smilg/rwm-kitty-caddy/docs/images/irl/bare.jpg

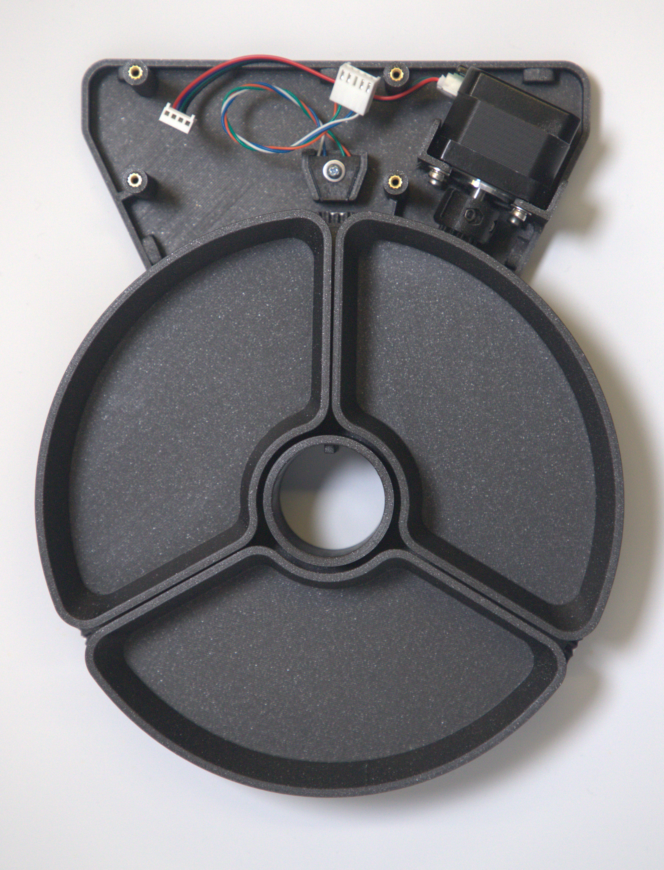
docs/images/irl/bare.jpg
