smilg/rwm-kitty-caddy/docs/images/irl/final_case_close.jpg

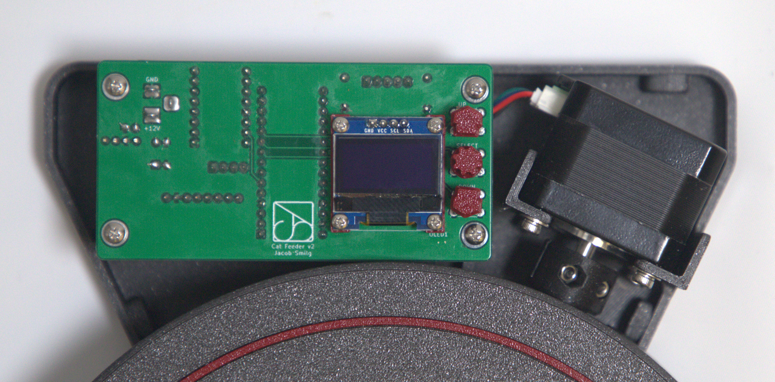
docs/images/irl/final_case_close.jpg
