smilg/rwm-kitty-caddy/docs/images/irl/final_case_off.jpg

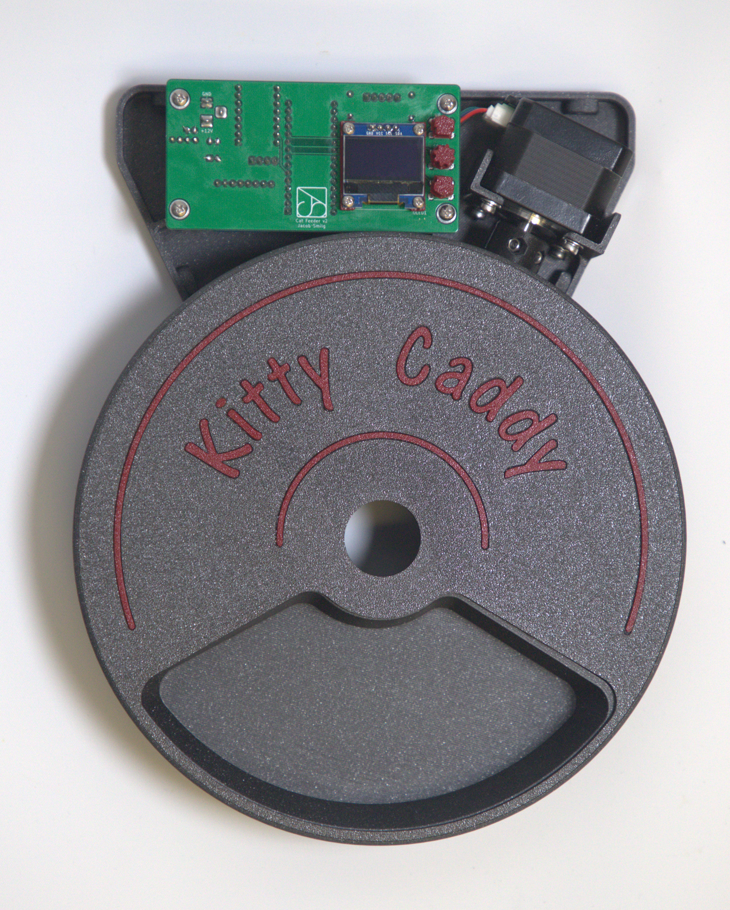
docs/images/irl/final_case_off.jpg
