smilg/rwm-kitty-caddy/ecad/CatFeeder.kicad_pcb

## KiCad design ecad/CatFeeder.kicad_pcb (2021-12-14)

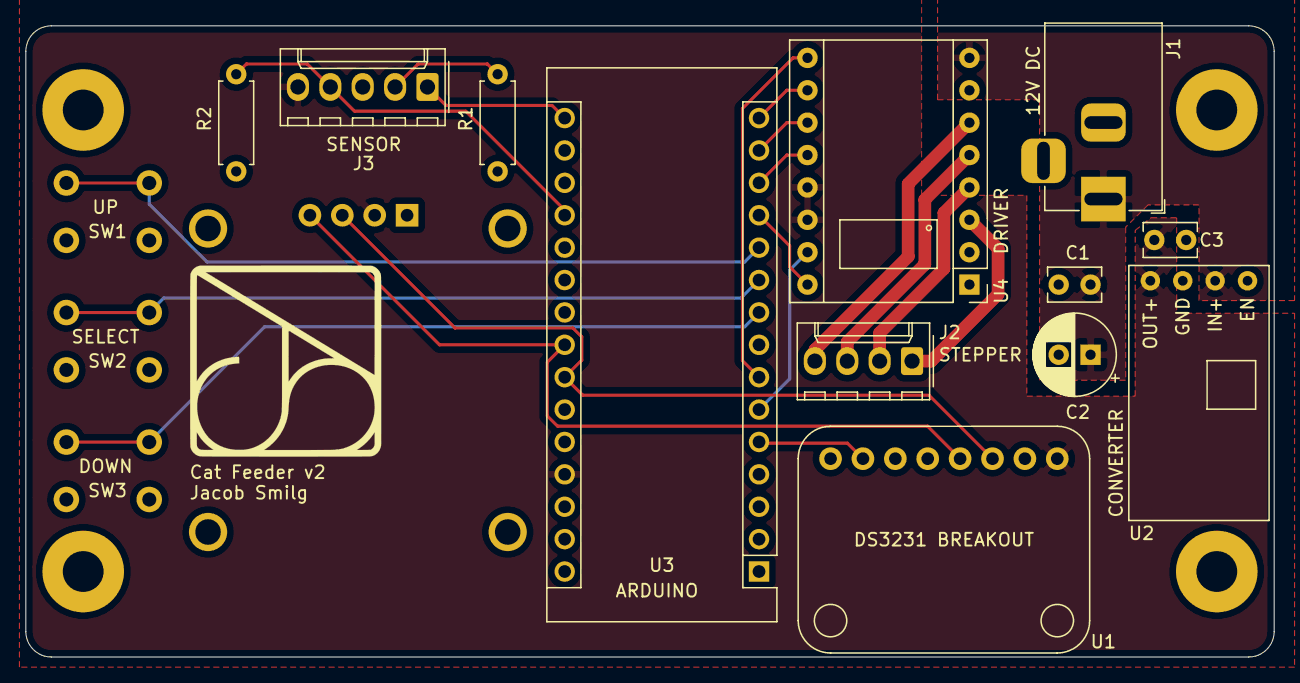
[picture p12: board CatFeeder.kicad_pcb from above]

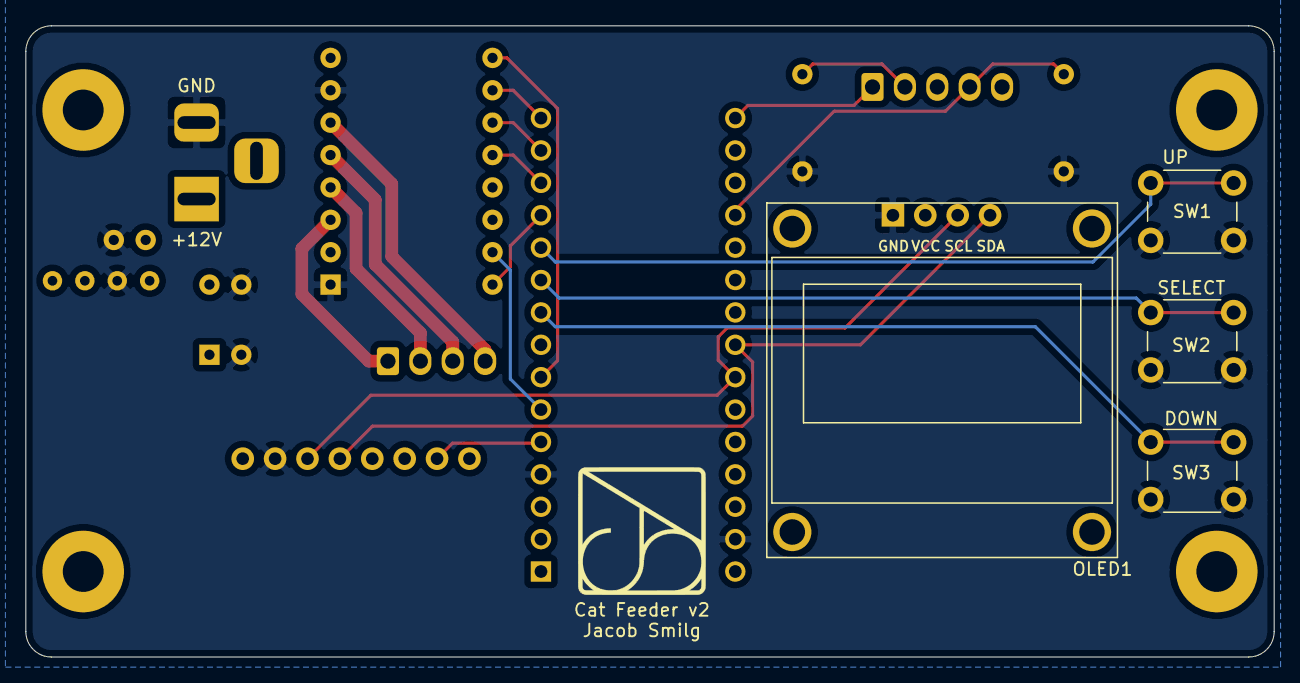
[picture p13: board CatFeeder.kicad_pcb from below]

Board: 2 copper layers, 97.9 x 49.5 mm, 16 parts (4 on the bottom side), 22 nets.

Parts:
C1, C3: 0.1μF; C_Rect_L4.0mm_W2.5mm_P2.50mm
C2: 100μF; CP_Radial_D6.3mm_P2.50mm
J1: Barrel_Jack; BarrelJack_Horizontal
J2: STEPPER; Molex_KK-254_AE-6410-04A_1x04_P2.54mm_Vertical
J3: OP740WZ; Molex_KK-254_AE-6410-05A_1x05_P2.54mm_Vertical
OLED1: I2COLEDDisplay; i2cOLED
R1: 100Ω; R_Axial_DIN0207_L6.3mm_D2.5mm_P7.62mm_Horizontal
R2: 100KΩ; R_Axial_DIN0207_L6.3mm_D2.5mm_P7.62mm_Horizontal
SW1: UP; SW_PUSH_6mm
SW2: SELECT; SW_PUSH_6mm
SW3: DOWN; SW_PUSH_6mm
U1: DS3231 BREAKOUT; DS3231Breakout
U2: BuckConverter; BuckConverterBreakout
U3: Arduino_Nano_v3.x; Arduino_Nano
U4: DRV8825; DRV8825Breakout

Connections:
1HZ_INT: U1.7, U3.5
+5V: C3.1, J3.5, OLED1.2, U1.1, U2.1, U3.27, U4.13, U4.14
+12V: C1.1, C2.1, J1.1, U2.3, U4.8
DIR: U3.12, U4.16
DOWN: SW3.2, U3.9
GND: C1.2, C2.2, C3.2, J1.2, OLED1.1, R1.2, R2.2, SW1.1, SW2.1, SW3.1, U1.2, U2.2, U3.4, U3.29, U4.1, U4.7
M0: U3.15, U4.10
M1: U3.14, U4.11
M2: U3.13, U4.12
unnamed: J2.1, U4.3
unnamed: J2.2, U4.4
unnamed: J2.3, U4.5
unnamed: J2.4, U4.6
unnamed: J3.2, R1.1
SCL: OLED1.3, U1.3, U3.24
SDA: OLED1.4, U1.4, U3.23
SELECT: SW2.2, U3.10
SENSOR: J3.4, R2.1, U3.19
SENSOR_ACTIVE: J3.1, U3.16
STEP: U3.6, U4.15
STEPPER_EN: U3.7, U4.9
UP: SW1.2, U3.11
