smilg/rwm-kitty-caddy/docs/images/irl/rev1_back_assembled.jpg

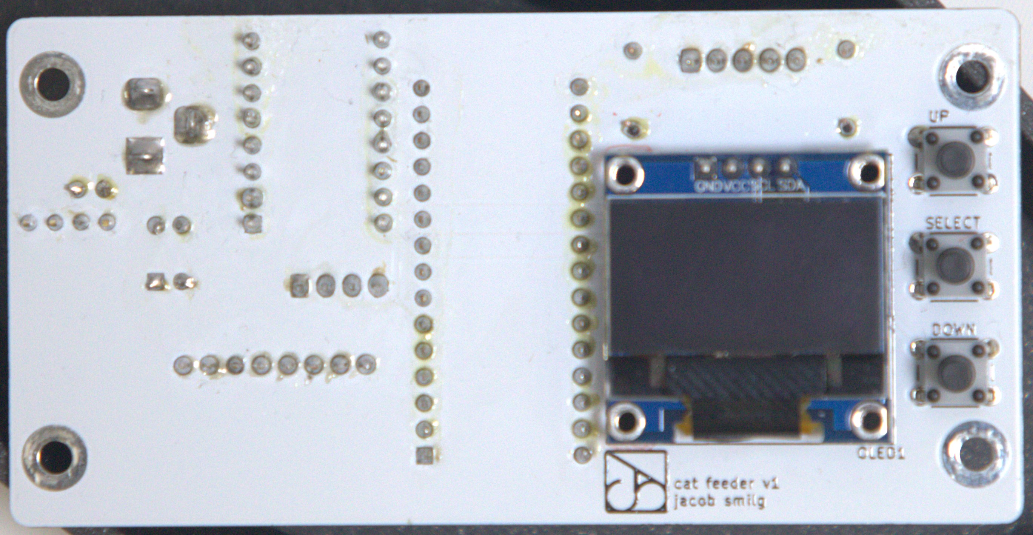
docs/images/irl/rev1_back_assembled.jpg
