smilg/rwm-kitty-caddy/docs/images/irl/rev1_front_assembled.jpg

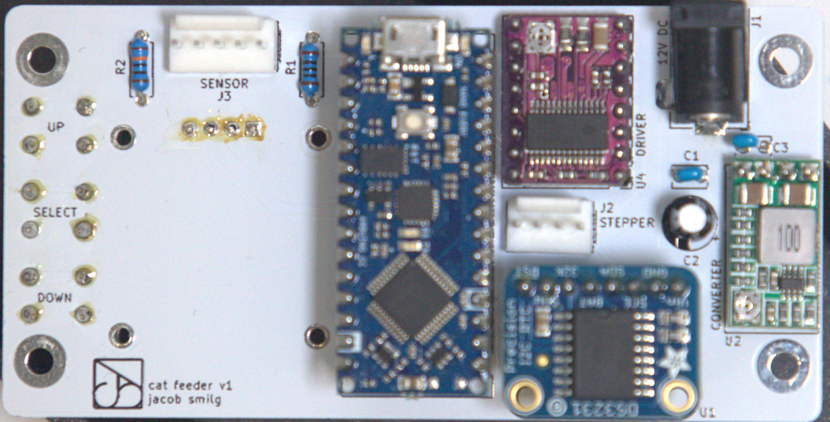
docs/images/irl/rev1_front_assembled.jpg
