smilg/rwm-kitty-caddy/(commit log)

2021-12-14 add ecad files
    [CatFeeder.kicad_pcb, CatFeeder.sch]
2021-12-14 add kicad images
